l1h2/line_follower/line_follower.ino

#include "include/battery/battery.h"
#include "include/logger/logger.h"
#include "include/receiver/receiver.h"
#include "include/state_machine/state_machine.h"
#include "include/timer/time.h"

void setup(void) {
    start_timer();  // Initialize system time tracking
    logger_init();
    receiver_init();
    battery_monitor_init();
}

int main(void) {
    setup();

    // if (is_battery_low()) {
    //     print("Battery low, shutting down...");
    //     return 1;
    // }

    run_state_machine();

    return 0;
}
