l1h2/line_follower/src/logger/logger.cpp

#include "../../include/logger/logger.h"

#include "../../include/timer/time.h"

static uint16_t last_log_time = 0;

void print_central_sensors(const SensorState *sensors) {
    for (uint8_t i = 0; i <= 8; i++) {
        if (i < 4) {
            print_bit(i, sensors->central_sensors_state);
        } else if (i == 4) {
            print_bool(sensors->central_sensor);
        } else if (i > 4) {
            print_bit(i - 1, sensors->central_sensors_state);
        }

        if (i != 8) print_string(" - ");
    }
}

void print_sensors(const SensorState *sensors) {
    print_bool(sensors->left_sensor);
    print_string(" | ");

    print_central_sensors(sensors);

    print_string(" | ");
    print_bool(sensors->right_sensor);

    print_string("\r\n");
    print_string("                    ");
    print_bool(sensors->middle_sensor);

    print_string("\r\n");
    print_string("******************************************");
    print_string("\r\n");
    print_string("\r\n");
}

void print_errors(const ErrorStruct *errors) {
    print_string("Error byte: ");
    print_binary(errors->sensors.central_sensors_state);
    print_string(" - Error: ");
    print_signed_byte(errors->error);
    print_string("\r\n");
    print_string("\r\n");
}

void print_diagnostics(const ErrorStruct *errors, const uint16_t interval) {
    if (!time_elapsed(last_log_time, interval)) return;

    last_log_time = time();
    print_errors(errors);
    print_sensors(&errors->sensors);
}
