l1h2/line_follower/src/logger/logger_debug.cpp

#include "../../include/logger/logger_debug.h"

#include "../../include/logger/logger_base.h"
#include "../../include/pid/errors.h"
#include "../../include/timer/time.h"
#include "../../include/vision/vision.h"

static uint32_t last_log_time = 0;

void debug_print_char(const char c) { print_char(c); }
void debug_print_bit(const uint8_t bit_position, const uint8_t byte) {
    print_bit(bit_position, byte);
}
void debug_print_byte(const uint8_t byte) { print_byte(byte); }
void debug_print_signed_byte(int8_t byte) { print_signed_byte(byte); }
void debug_print_word(const uint16_t word) { print_word(word); }
void debug_print_signed_word(int16_t word) { print_signed_word(word); }
void debug_print_binary(const uint8_t byte) { print_binary(byte); }
void debug_print_bool(const bool value) { print_bool(value); }
void debug_print_string(const char *str) { print_string(str); }
void debug_print_new_line(void) { print_new_line(); }
void debug_print(const char *str) { print(str); }

void debug_print_central_sensors(void) {
    const SensorState *sensors = get_sensors();

    for (uint8_t i = 0; i <= 8; i++) {
        if (i < 4) {
            print_bit(i, sensors->central_sensors_state);
        } else if (i == 4) {
            print_bool(sensors->central_sensor);
        } else if (i > 4) {
            print_bit(i - 1, sensors->central_sensors_state);
        }

        if (i != 8) print_string(" - ");
    }
}

void debug_print_sensors(void) {
    const SensorState *sensors = get_sensors();

    print_bool(sensors->left_sensor);
    print_string(" | ");

    debug_print_central_sensors();

    print_string(" | ");
    print_bool(sensors->right_sensor);

    print_new_line();
    print_string("                    ");
    print_bool(sensors->middle_sensor);

    print_new_line();
    print_string("******************************************");
    print_new_line();
}

void debug_print_errors(void) {
    const ErrorStruct *errors = get_errors();

    print_new_line();
    print_string("Error byte: ");
    print_binary(errors->sensors->central_sensors_state);
    print_string(" - Error: ");
    print_signed_byte(errors->error);
    print_string(" - Last error: ");
    print_signed_byte(errors->filtered_delta_error);
    print_string(" - Error sum: ");
    print_signed_word(errors->error_sum);
    print_new_line();
}

void debug_print_diagnostics(const uint32_t interval) {
    if (!time_elapsed(last_log_time, interval)) return;

    last_log_time = time();
    debug_print_errors();
    debug_print_sensors();
}

void debug_print_forward_sensors(void) {
    const ErrorStruct *errors = get_errors();

    print_bool(errors->sensors->left_sensor);
    print_reverse_binary(errors->sensors->central_sensors_state);
    print_bool(errors->sensors->right_sensor);
    print_new_line();
}
