l1h2/line_follower/(commit log)

2025-04-15 Feat: Add improved PID controller with filters
2025-04-15 Feat: Add break logic without stopping the PID controller
2025-04-16 Feat: Separate error and PID logic
    Feat: Add vision functionality for mapping track
    [errors.cpp, line_follower.ino, logger.cpp, pid.cpp]
2025-04-16 Feat: Improved debounce logic for track marker checks with more precise timers.
    Refactor: Decouple vision and track information logic from PID controller.
    Refactor: Create time interface that provides clock functionality without exposing HAL logic, keeping the HAL functionality in the same place.
    Refactor: Separate core logging functionality into its own file while keeping the higher-level logging interface in the same place.
2025-04-17 Refactor: Decouple error update logic for last_error and delta_error
    [errors.cpp]
2025-04-18 Docs: Add Sensor observer interactive truth table
    [Sensors Observer.xlsx]
2025-04-19 Feat: Add improved observer logic, as well as interactive spreadsheet for testing the robot's expected identifications based on sensor data
    [Sensors Observer.xlsx]
2025-04-20 Docs: Update project structure in README to better reflect the current state of the project
2025-04-24 Fix: Major HAL overhaul after physical testing to account for real behavior and mixed register configurations
    [config.h, logger_base.cpp, pid.cpp]
2025-04-25 Feat: Move Error and Sensor structs to singleton pattern.
    Feat: Add running test mode for easier debugging.
    Refactor: Change some dir and file names to better reflect the functionality in them.
    [config.h, errors.cpp]
2025-04-25 Feat: Create real time logging through bluetooth to allow for better debugging of operational conditions
    [Sensors Observer.xlsx]
2025-04-26 Feat: Prepare codebase for integration with bluetooth module and remote controls
    [Sensors Observer.xlsx]
2025-04-28 Fix: Minor fixes to the serial communication protocol
    [line_follower.ino, logger_base.cpp, usart.cpp]
2025-04-29 Feat: Implement millisecond and microsecond precision timers
2025-04-30 Feat: Add battery monitor, and the corresponding messages to the bluetooth protocol
2025-04-30 Fix: Update PID controller to improve performance.
    [adc.cpp, errors.cpp, line_follower.ino, logger_debug.cpp, pid.cpp]
2025-05-06 Feat: Implement feed forward component to PID controller
    Refactor: Organize changes made during the RSM competition
    Fix: Change getters of global structs to const as they are only meant to be used for reading outside the owner file
    [errors.cpp]
2025-05-06 Feat: Add brake factor to the base speed controller
2025-05-13 Fix: Add binary data signaling for running to stopped transition
    [Sensors Observer.xlsx]
2025-05-15 Feat: Implement line tracking for PET track.
